arsalan0004/word_watch/(commit log)

2021-06-28 all words turn on, RTC clock initialized correctly
    [main.ino]
2021-06-28 added interrupt to button pin
2021-06-30 watch now uses millis() to determine how long the button has beeen clicked for, not delay()
2021-07-05 refactored, but now button pin won't stabilize on high voltage
    [main.ino]
2021-07-08 fixed voltage instability on button pin, as mentioned in previous commit
    [main.ino]
2021-10-24 added circuitboard photo
